nealjack/BMO/hardware/bmo_power/bmo_power.kicad_pcb

## KiCad design hardware/bmo_power/bmo_power.kicad_pcb (2026-06-14)

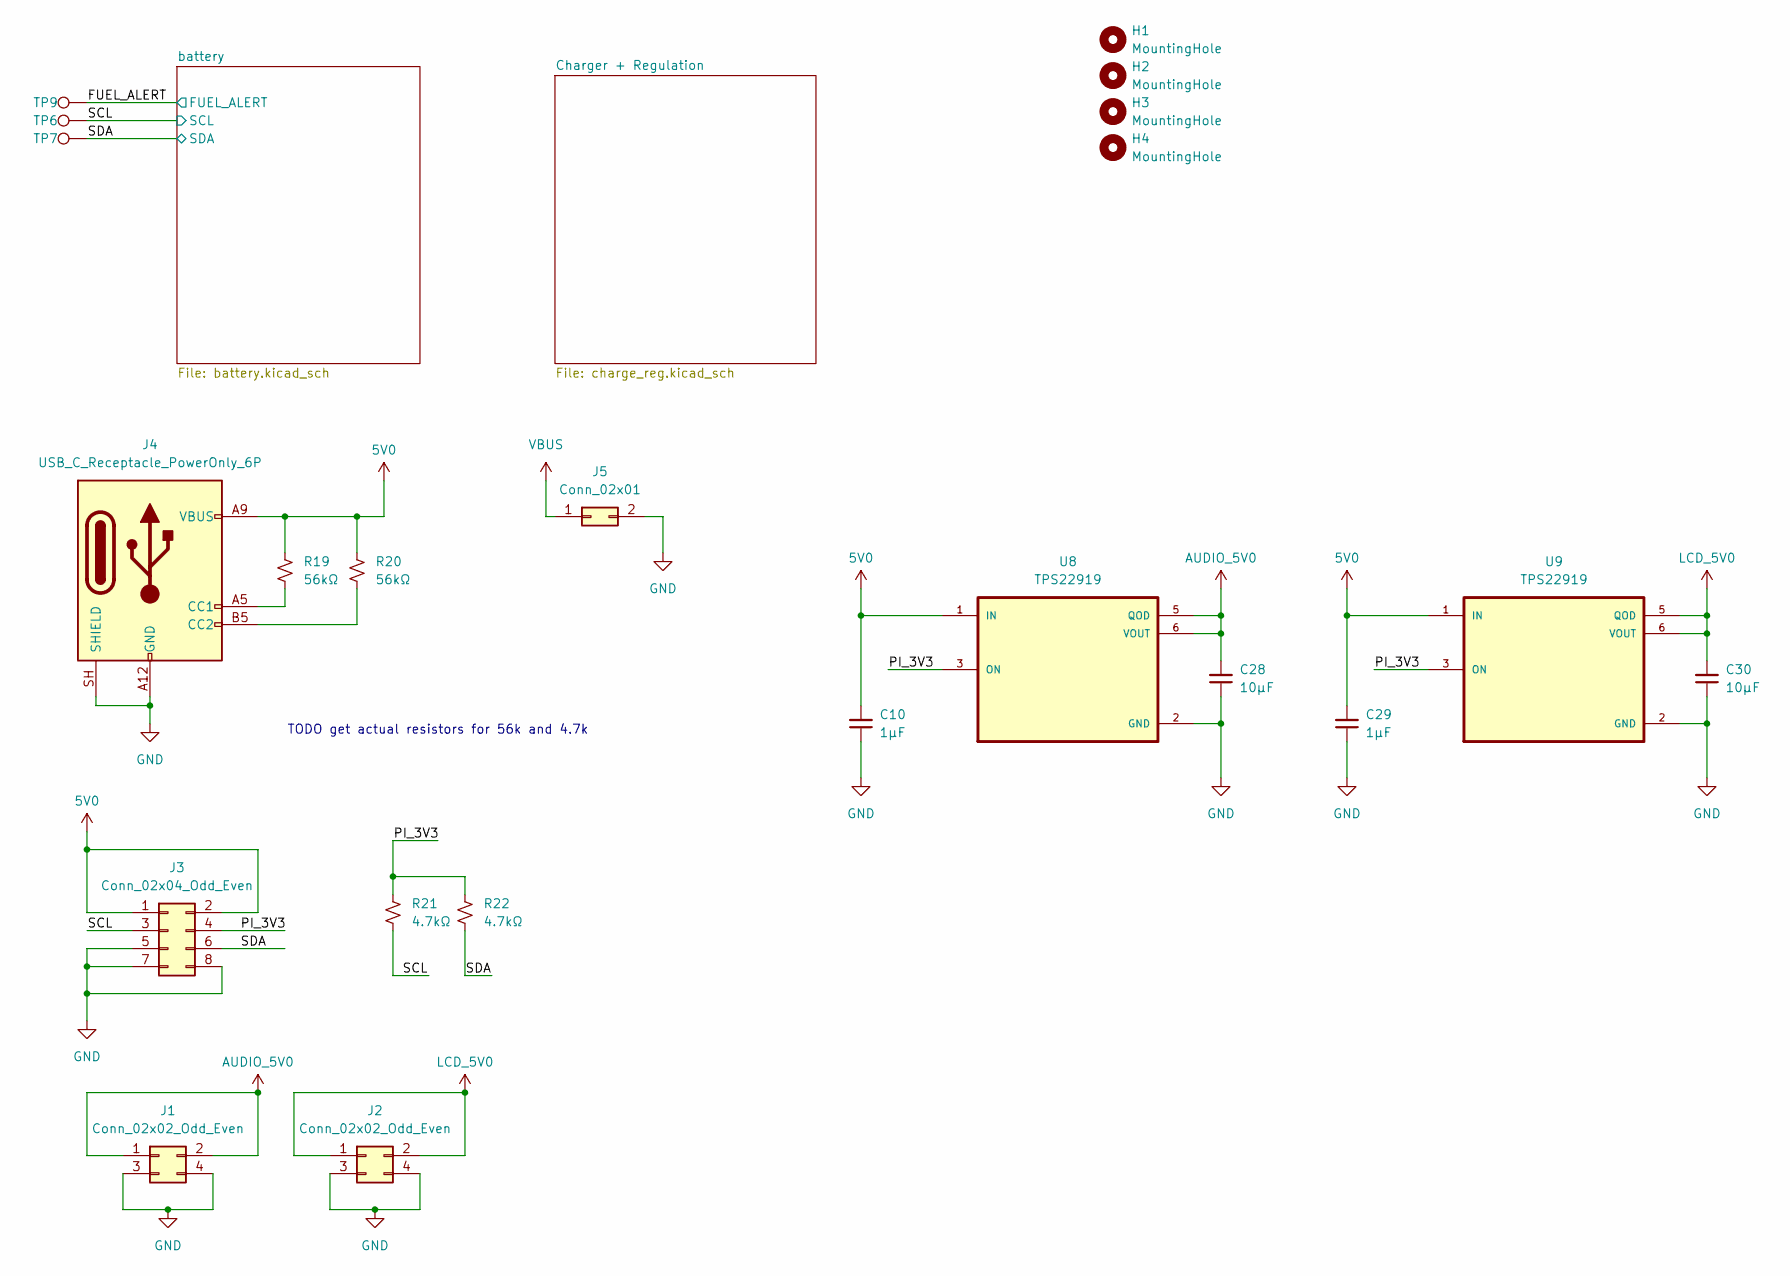
[picture p1: schematic bmo_power.kicad_sch]

Parts:
C10, C29: 1µF; C_0402_1005Metric_Pad0.74x0.62mm_HandSolder; MPN CL05A105KP5NNNC; Digikey 1276-1076-1-ND
C28, C30: 10µF; C_0402_1005Metric_Pad0.74x0.62mm_HandSolder; MPN GRM155R61A106ME11D; Digikey GRM155R61A106ME11D
H1, H2, H3, H4: MountingHole; MountingHole_2.7mm_M2.5
J1, J2: Conn_02x02_Odd_Even; PinHeader_2x02_P2.54mm_Vertical
J3: Conn_02x04_Odd_Even; PinHeader_2x04_P2.54mm_Vertical
J4: USB_C_Receptacle_PowerOnly_6P; USB_C_Receptacle_GCT_USB4125-xx-x-0190_6P_TopMnt_Horizontal
J5: Conn_02x01; PinSocket_2x01_P2.54mm_Vertical
R19, R20: 56kΩ; R_0402_1005Metric_Pad0.72x0.64mm_HandSolder; MPN RMCF0402FT10K0; Digikey RMCF0402FT10K0CT-ND
R21, R22: 4.7kΩ; R_0402_1005Metric_Pad0.72x0.64mm_HandSolder; MPN RMCF0402FT10K0; Digikey RMCF0402FT10K0CT-ND
TP6, TP7, TP9: TestPoint; TestPoint_Pad_2.0x2.0mm
U8, U9: TPS22919; SOT-363_SC-70-6

Connections:
5V0: C10.2, C29.2, J3.1, J3.2, J4.A9 (VBUS), J4.B9 (VBUS), R19.1, R20.1, U8.1 (IN), U9.1 (IN); also elsewhere on the board
/FUEL_ALERT: TP9.1 (1_1); also elsewhere on the board
/PI_3V3: J3.4, R21.1, R22.1, U8.3 (ON), U9.3 (ON)
/SCL: J3.3, R21.2, TP6.1 (1_1); also elsewhere on the board
/SDA: J3.6, R22.2, TP7.1 (1_1); also elsewhere on the board
AUDIO_5V0: C28.2, J1.1, J1.2, U8.5 (QOD), U8.6 (VOUT)
GND: C10.1, C28.1, C29.1, C30.1, J1.3, J1.4, J2.3, J2.4, J3.5, J3.7, J3.8, J4.A12 (GND), J4.B12 (GND), J4.SH (SHIELD), J5.2, U8.2 (GND), U9.2 (GND); also elsewhere on the board
LCD_5V0: C30.2, J2.1, J2.2, U9.5 (QOD), U9.6 (VOUT)
unnamed: J4.A5 (CC1), R19.2
unnamed: J4.B5 (CC2), R20.2
VBUS: J5.1; also elsewhere on the board

Notes on the sheet:
TODO get actual resistors for 56k and 4.7k

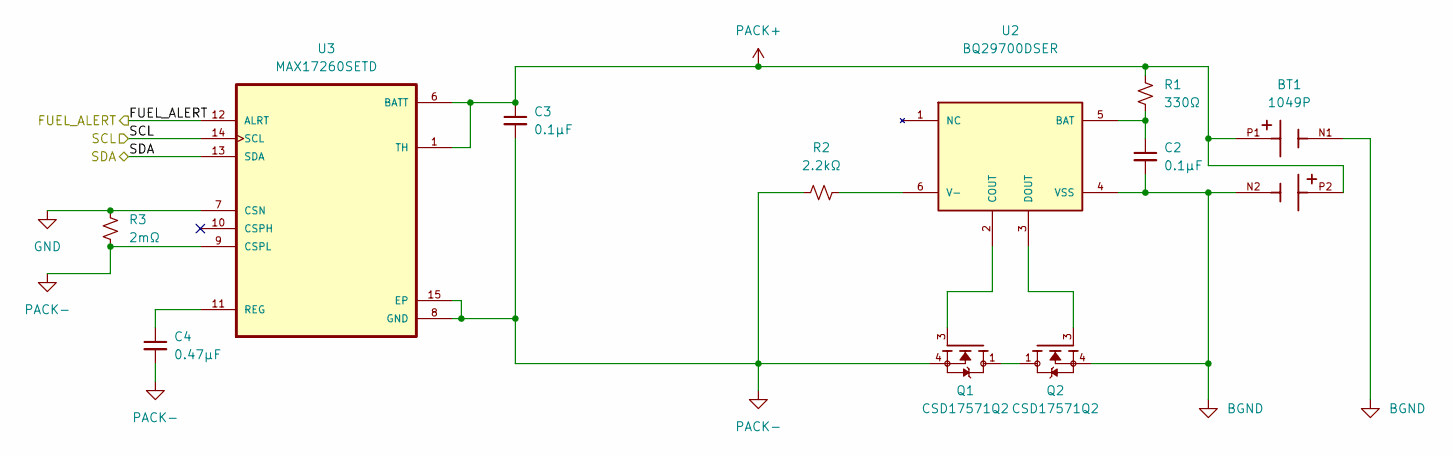
[picture p2: schematic battery.kicad_sch]

Parts:
BT1: 1049P; BAT_1049P; PARTREV F
C2, C3: 0.1μF; C_0402_1005Metric_Pad0.74x0.62mm_HandSolder; Tolerance 10%; Voltage 10V; MPN GRM155R61A104KA01D; Digikey 490-1318-2-ND
C4: 0.47μF; C_0402_1005Metric_Pad0.74x0.62mm_HandSolder; Tolerance 10%; Voltage 6.3V; MPN GRM155R60J474KE19D; Digikey 490-3266-1-ND
Q1, Q2: CSD17571Q2; TRANS_CSD17571Q2; PARTREV A
R1: 330Ω; R_0402_1005Metric_Pad0.72x0.64mm_HandSolder; MPN RMCF0402JT330R; Digikey RMCF0402JT330RCT-ND
R2: 2.2kΩ; R_0402_1005Metric_Pad0.72x0.64mm_HandSolder; Tolerance 5%; MPN RMCF0402JT2K20; Digikey RMCF0402JT2K20TR-ND
R3: 2mΩ; R_2512_6332Metric; Tolerance 1%; MPN CSNL2512FT2L00; Digikey CSNL2512FT2L00CT-ND
U2: BQ29700DSER; SON50P150X150X80-6N; PARTREV G
U3: MAX17260SETD; SON40P300X300X80-15N

Connections:
/FUEL_ALERT: U3.12 (ALRT); also elsewhere on the board
/SCL: U3.14 (SCL); also elsewhere on the board
/SDA: U3.13 (SDA); also elsewhere on the board
BGND: BT1.N1, BT1.N2, C2.2, Q2.4, Q2.8, U2.4 (VSS)
GND: R3.1, U3.7 (CSN); also elsewhere on the board
unnamed: Q1.1, Q1.2, Q1.5, Q1.6, Q1.7, Q2.1, Q2.2, Q2.5, Q2.6, Q2.7
unnamed: C2.1, R1.1, U2.5 (BAT)
unnamed: Q1.3, U2.2 (COUT)
unnamed: Q2.3, U2.3 (DOUT)
unnamed: R2.2, U2.6 (V-)
unnamed: C4.1, U3.11 (REG)
PACK+: BT1.P1, BT1.P2, C3.1, R1.2, U3.1 (TH), U3.6 (BATT); also elsewhere on the board
PACK-: C3.2, C4.2, Q1.4, Q1.8, R2.1, R3.2, U3.8 (GND), U3.9 (CSPL), U3.15 (EP)

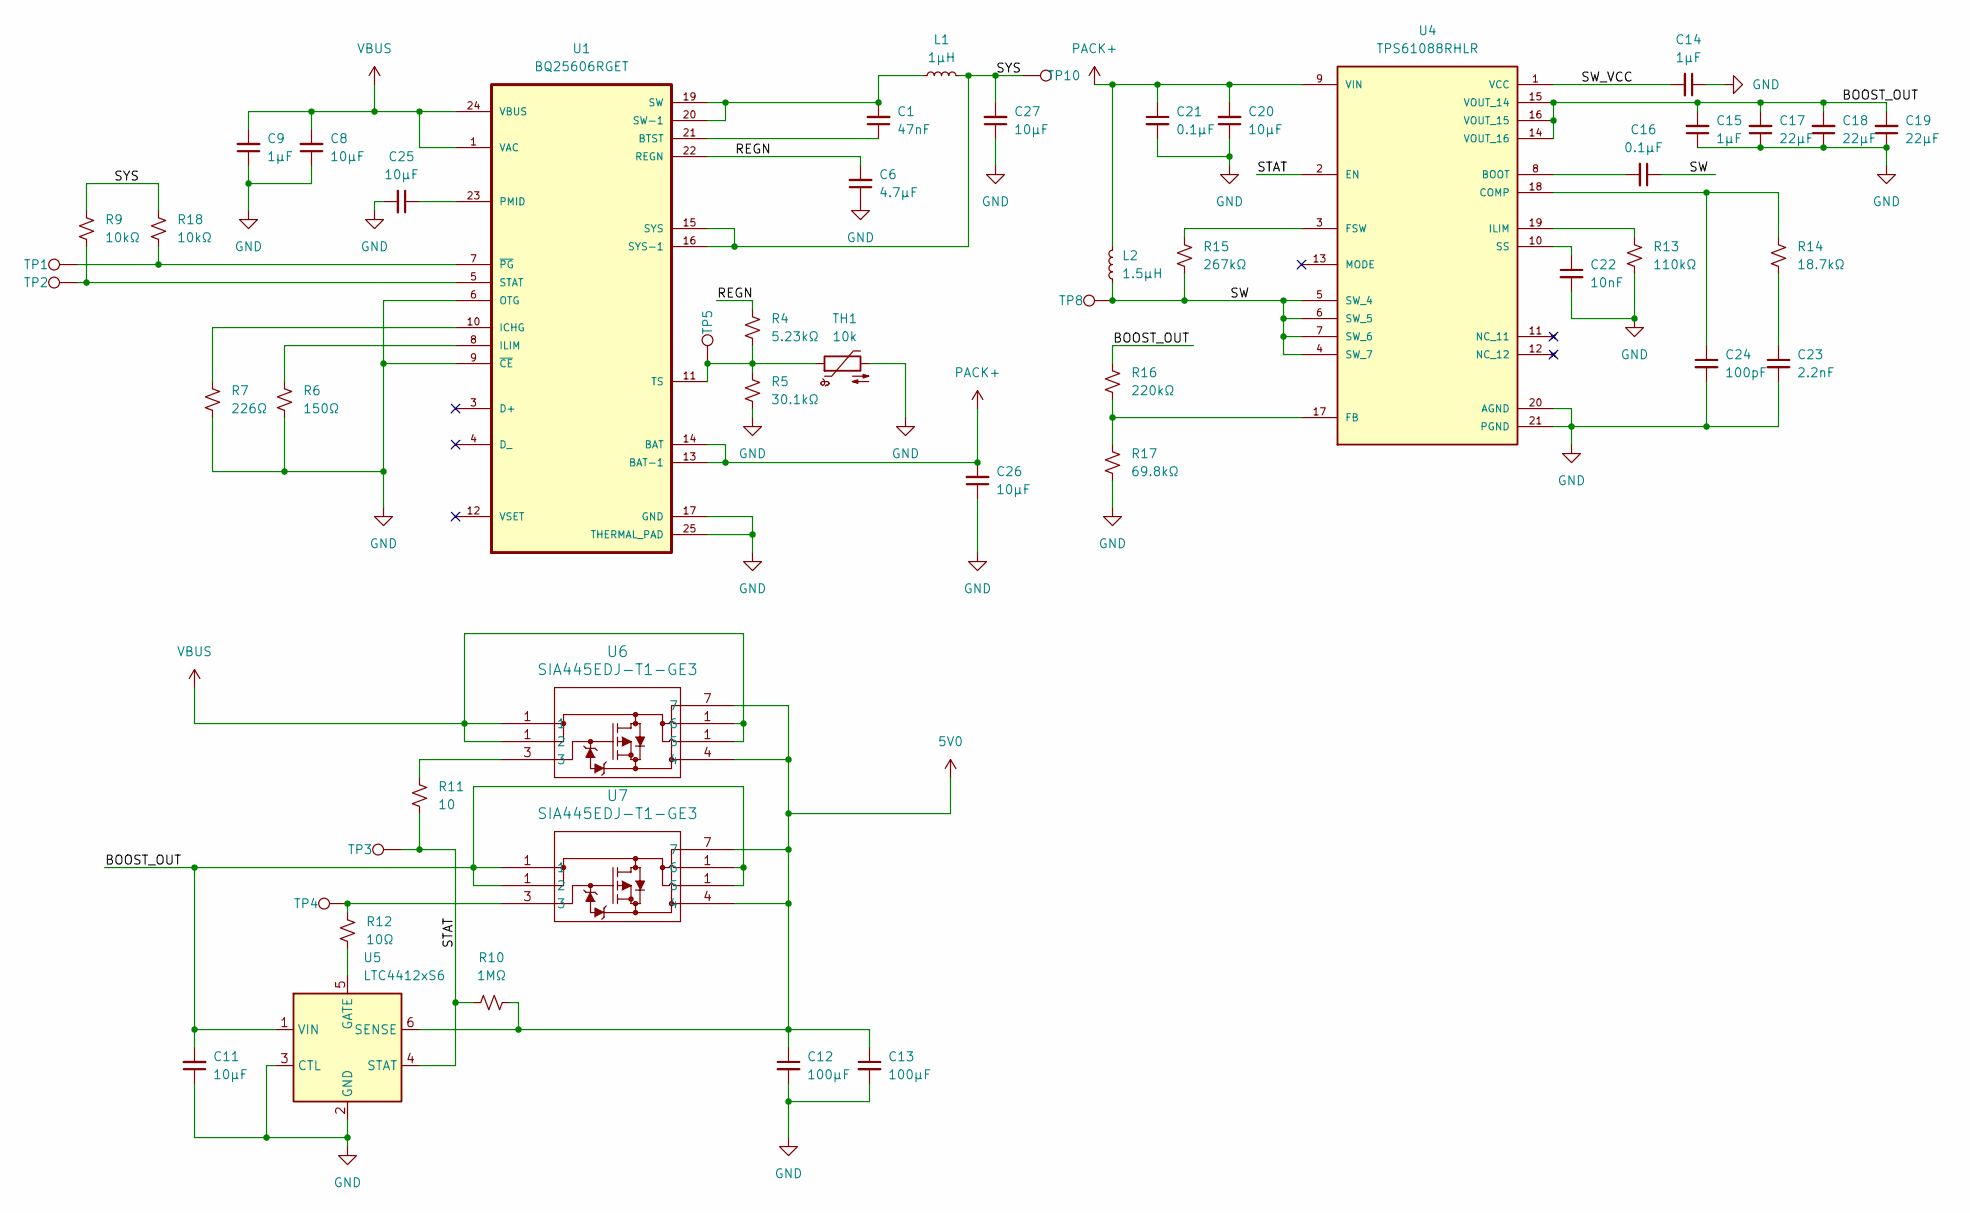
[picture p3: schematic charge_reg.kicad_sch]

Parts:
C1: 47nF; C_0402_1005Metric_Pad0.74x0.62mm_HandSolder; MPN GRM155R61A473KA01D; Digikey 490-5412-1-ND
C6: 4.7µF; C_0402_1005Metric_Pad0.74x0.62mm_HandSolder; MPN CL05A475MP5NRNC; Digikey 1276-1482-1-ND
C8, C11, C20, C25, C26, C27: 10µF; C_0402_1005Metric_Pad0.74x0.62mm_HandSolder; MPN GRM155R61A106ME11D; Digikey GRM155R61A106ME11D
C9, C14, C15: 1µF; C_0402_1005Metric_Pad0.74x0.62mm_HandSolder; MPN CL05A105KP5NNNC; Digikey 1276-1076-1-ND
C12, C13: 100µF; C_1206_3216Metric; MPN GRM31CR61A107MEA8L; Digikey 490-GRM31CR61A107MEA8LCT-ND
C16, C21: 0.1μF; C_0402_1005Metric_Pad0.74x0.62mm_HandSolder; Tolerance 10%; Voltage 10V; MPN GRM155R61A104KA01D; Digikey 490-1318-2-ND
C17, C18, C19: 22µF; C_0603_1608Metric; MPN CL10A226MP8NUNE; Digikey 1276-1274-1-ND
C22: 10nF; C_0402_1005Metric_Pad0.74x0.62mm_HandSolder; Tolerance 10%; Voltage 10V; MPN GRM155R61A103KA01D; Digikey 490-6296-1-ND
C23: 2.2nF; C_0402_1005Metric_Pad0.74x0.62mm_HandSolder; Tolerance 10%; Voltage 10V; MPN CC0402KRX7R6BB222; Digikey 311-3792-1-ND
C24: 100pF; C_0402_1005Metric_Pad0.74x0.62mm_HandSolder; Tolerance 10%; Voltage 10V; MPN CC0402KRX7R6BB101; Digikey 13-CC0402KRX7R6BB101CT-ND
L1: 1μH; L_Vishay_IHLP-2020; MPN IHLP2020ABER1R0M01; Digikey 541-1704-1-ND
L2: 1.5µH; 74439324015; MPN 74439324015; Digikey 732-74439324015CT-ND
R4: 5.23kΩ; R_0402_1005Metric_Pad0.72x0.64mm_HandSolder; MPN RC0402FR-075K23L; Digikey YAG3195CT-ND
R5: 30.1kΩ; R_0402_1005Metric_Pad0.72x0.64mm_HandSolder; MPN RC0402FR-0730K1L; Digikey 311-30.1KLRCT-ND
R6: 150Ω; R_0402_1005Metric_Pad0.72x0.64mm_HandSolder; MPN ERJ-2RKF1500X; Digikey P150LCT-ND
R7: 226Ω; R_0402_1005Metric_Pad0.72x0.64mm_HandSolder; MPN RMCF0402FT226R; Digikey RMCF0402FT226RCT-ND
R9, R18: 10kΩ; R_0402_1005Metric_Pad0.72x0.64mm_HandSolder; MPN RMCF0402FT10K0; Digikey RMCF0402FT10K0CT-ND
R10: 1MΩ; R_0402_1005Metric_Pad0.72x0.64mm_HandSolder; MPN RC0402FR-071ML; Digikey 311-1.00MLRCT-ND
R11: 10; R_0402_1005Metric_Pad0.72x0.64mm_HandSolder; MPN RC0402FR-0710RL; Digikey 311-10.0LRCT-ND
R12: 10Ω; R_0402_1005Metric_Pad0.72x0.64mm_HandSolder; MPN RC0402FR-0710RL; Digikey 311-10.0LRCT-ND
R13: 110kΩ; R_0402_1005Metric_Pad0.72x0.64mm_HandSolder; MPN RC0402FR-07110KL; Digikey 311-110KLRCT-ND
R14: 18.7kΩ; R_0402_1005Metric_Pad0.72x0.64mm_HandSolder; MPN RMCF0402FT18K7; Digikey RMCF0402FT18K7CT-ND
R15: 267kΩ; R_0402_1005Metric_Pad0.72x0.64mm_HandSolder; MPN RMCF0402FT267K; Digikey RMCF0402FT267KCT-ND
R16: 220kΩ; R_0402_1005Metric_Pad0.72x0.64mm_HandSolder; MPN RC0402FR-07220KL; Digikey 311-220KLRCT-ND
R17: 69.8kΩ; R_0402_1005Metric_Pad0.72x0.64mm_HandSolder; MPN RMCF0402FT69K8; Digikey RMCF0402FT69K8CT-ND
TH1: 10k; PinHeader_1x02_P2.54mm_Vertical; MPN 103AT-2; Digikey 4316-103AT-2-ND
TP1, TP2, TP3, TP4, TP5, TP8, TP10: TestPoint; TestPoint_Pad_2.0x2.0mm
U1: BQ25606RGET; QFN50P400X400X100-25N
U4: TPS61088RHLR; IC_TPS61088RHLR; PARTREV 4219071/A 05/2017
U5: LTC4412xS6; TSOT-23-6
U6, U7: SIA445EDJ-T1-GE3; Vishay_PowerPAK_SC70-6L_Single

Connections:
5V0: C12.1, C13.1, R10.2, U5.6 (SENSE), U6.4, U6.7, U7.4, U7.7; also elsewhere on the board
/Charger + Regulation/BOOST_OUT: C11.2, C15.2, C17.2, C18.2, C19.2, R16.1, U4.14 (VOUT_16), U4.15 (VOUT_14), U4.16 (VOUT_15), U5.1 (VIN), U7.1
/Charger + Regulation/REGN: C6.2, R4.1, U1.22 (REGN)
/Charger + Regulation/STAT: R10.1, R11.2, TP3.1 (1_1), U4.2 (EN), U5.4 (STAT)
/Charger + Regulation/SW: C16.1, L2.1, R15.2, TP8.1 (1_1), U4.4 (SW_7), U4.5 (SW_4), U4.6 (SW_5), U4.7 (SW_6)
/Charger + Regulation/SW_VCC: C14.2, U4.1 (VCC)
/Charger + Regulation/SYS: C27.2, L1.2, R9.1, R18.1, TP10.1 (1_1), U1.15 (SYS), U1.16 (SYS-1)
GND: C6.1, C8.1, C9.1, C11.1, C12.2, C13.2, C14.1, C15.1, C17.1, C18.1, C19.1, C20.1, C21.2, C22.2, C23.2, C24.2, C25.2, C26.1, C27.1, R5.2, R6.1, R7.1, R13.1, R17.2, TH1.2, U1.6 (OTG), U1.9 (~CE), U1.17 (GND), U1.18 (GND), U1.25 (THERMAL_PAD), U4.20 (AGND), U4.21 (PGND), U4.22 (PGND), U4.23 (PGND), U4.24 (PGND), U4.25 (PGND), U4.26 (PGND), U4.27 (PGND), U4.28 (PGND), U4.29 (PGND), U5.2 (GND), U5.3 (CTL); also elsewhere on the board
unnamed: C23.1, R14.1
unnamed: R11.1, U6.3
unnamed: R12.1, TP4.1 (1_1), U7.3
unnamed: C1.1, U1.21 (BTST)
unnamed: R7.2, U1.10 (ICHG)
unnamed: R6.2, U1.8 (ILIM)
unnamed: C25.1, U1.23 (PMID)
unnamed: R9.2, TP2.1 (1_1), U1.5 (STAT)
unnamed: C1.2, L1.1, U1.19 (SW), U1.20 (SW-1)
unnamed: R4.2, R5.1, TH1.1, TP5.1 (1_1), U1.11 (TS)
unnamed: R18.2, TP1.1 (1_1), U1.7 (~PG)
unnamed: C16.2, U4.8 (BOOT)
unnamed: C24.1, R14.2, U4.18 (COMP)
unnamed: R16.2, R17.1, U4.17 (FB)
unnamed: R15.1, U4.3 (FSW)
unnamed: R13.2, U4.19 (ILIM)
unnamed: C22.1, U4.10 (SS)
unnamed: R12.2, U5.5 (GATE)
PACK+: C20.2, C21.1, C26.2, L2.2, U1.13 (BAT-1), U1.14 (BAT), U4.9 (VIN); also elsewhere on the board
VBUS: C8.2, C9.2, U1.1 (VAC), U1.24 (VBUS), U6.1; also elsewhere on the board

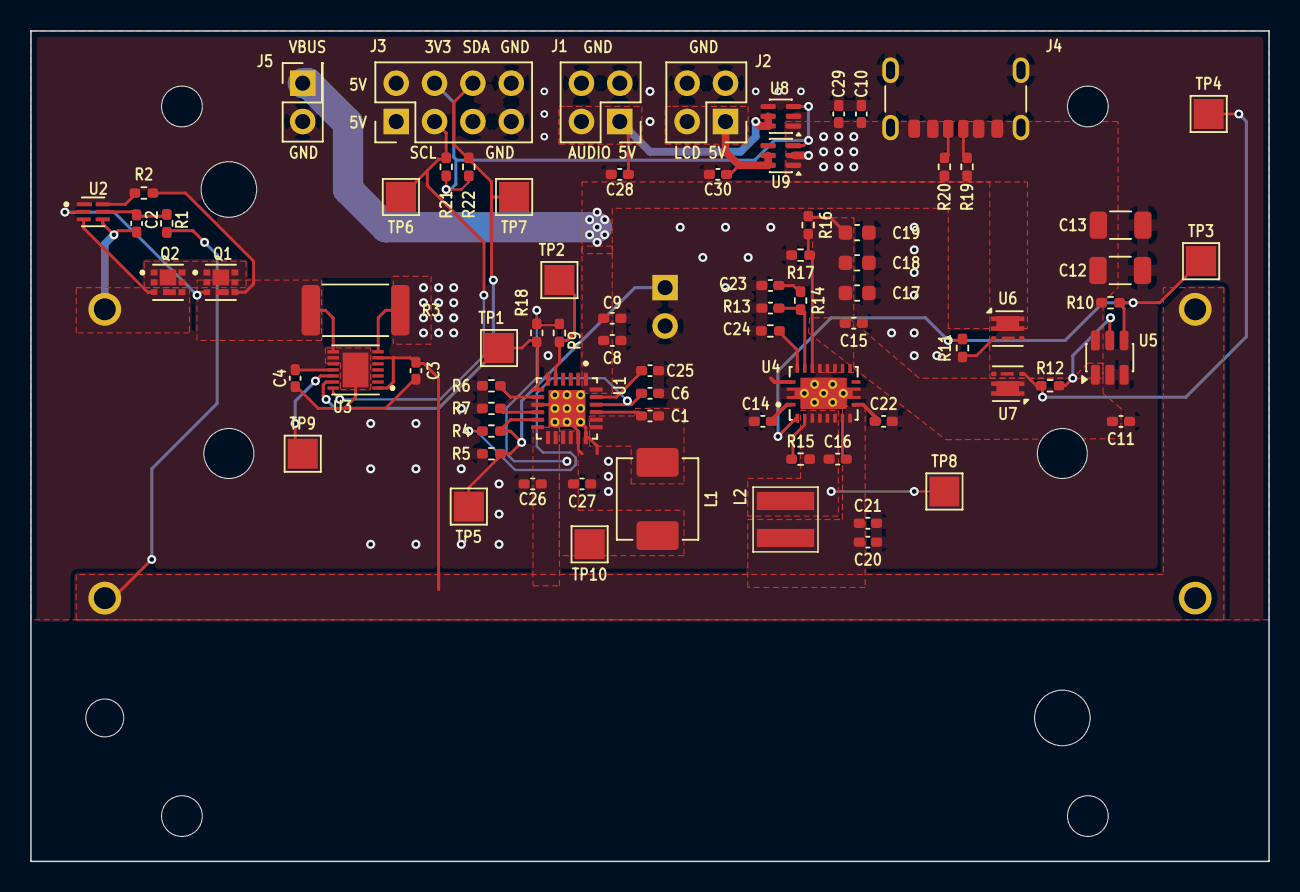
[picture p4: board bmo_power.kicad_pcb from above]

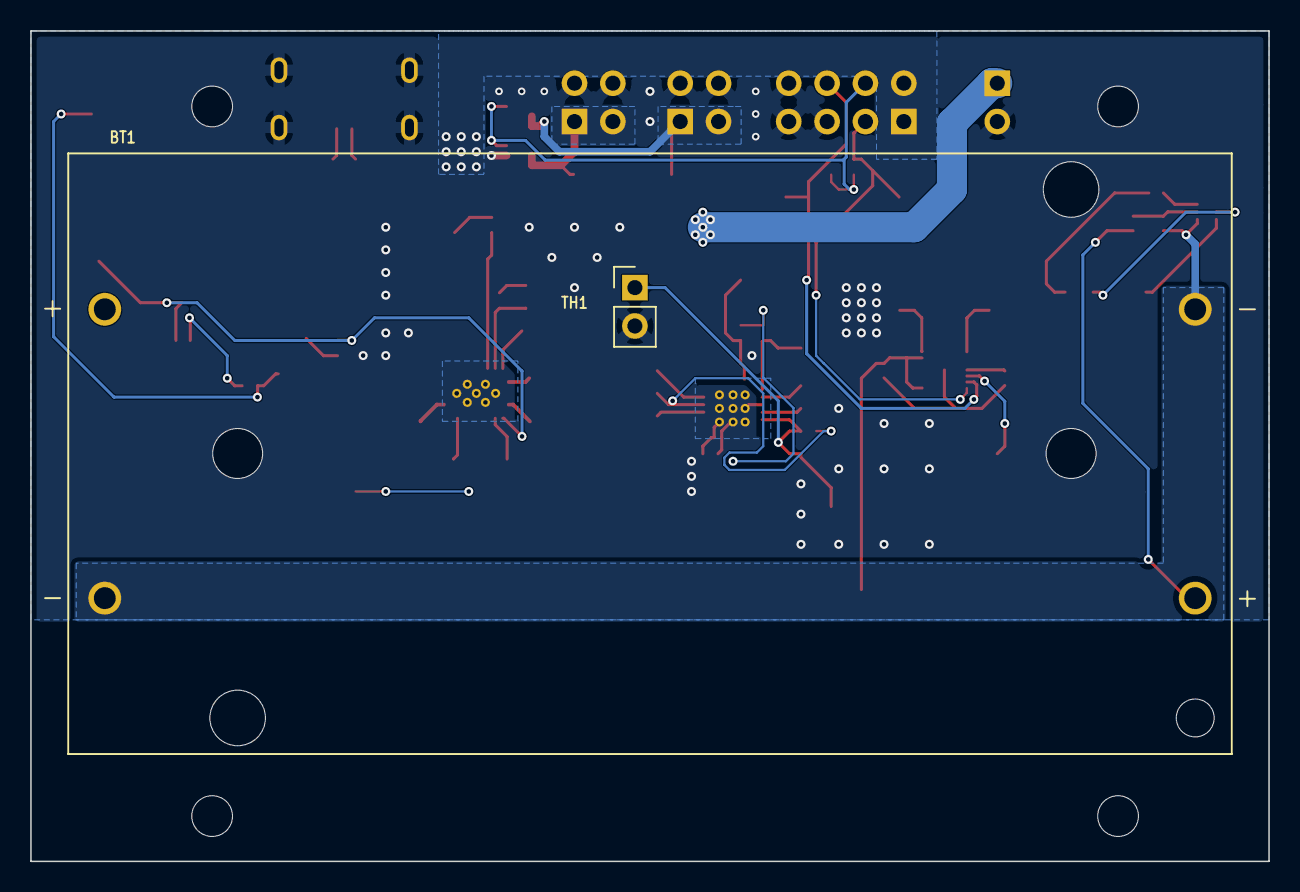
[picture p5: board bmo_power.kicad_pcb from below]

Board: 2 copper layers, 82.0 x 55.0 mm, 83 parts (2 on the bottom side), 44 nets.
