nealjack/BMO/(commit log)

2026-05-03 Add wip power board
    [1049P.step, BQ25606RGET.step, BQ25798RQMR.step, BQ29700DSER.step, CSD17571Q2.step, MAX17260SETD_.step, battery.kicad_sch, bmo.kicad_pcb]
2026-05-03 wip start ltc4412 addition
    [battery.kicad_sch, charge_reg.kicad_sch]
2026-06-13 Placed and routed everything. DRC is clean.
    [battery.kicad_sch, bmo.kicad_pcb, bmo.kicad_sch, charge_reg.kicad_sch]
2026-06-13 rename to bmo_power for power board
    [1049P.step, BQ25606RGET.step, BQ25798RQMR.step, BQ29700DSER.step, CSD17571Q2.step, MAX17260SETD_.step, battery.kicad_sch, bmo_power.kicad_pcb]
2026-06-14 embed 3d models
    [battery.kicad_sch, bmo_power.kicad_pcb, bmo_power.kicad_sch, charge_reg.kicad_sch]
